airpocket-soundman/pcb_design_test/pcba/README.md

# PCBA production release with M5Bus socket

This directory contains the connector-focused PCBA package derived from the exact upstream reproduction.

## Port mapping

| Port | PCB designators | Required color | LCSC assignment |
|---|---|---|---|
| A | CN2, CN3 | Red | C22390444 / XUNPU WAFER-HY2.0-4PWZ-R62 |
| B | CN4 | Black | hanxia HX-HY2.0-4PWZ-B; obtain the current JLCPCB/LCSC C-number at quotation |
| C | CN5 | Beige / standard | hanxia HX-HY2.0-4PWZ |
| D | CN6 | Beige / standard | hanxia HX-HY2.0-4PWZ |
| E | CN7 | Beige / standard | hanxia HX-HY2.0-4PWZ |

CN1 is the optional vertical Grove connector in the upstream design and is DNP in this release.

## M5Bus

| Side | Designator | LCSC | Part |
|---|---|---|---|
| Top header | J10 | C19630981 | Kinghelm KH-2.54PH-2X15P-L11.0-SMT |
| Bottom low-profile socket | J11 | C41382298 | Yxcon F136-1215A0CMUB1, 3.55 mm insulation height |

Both positions are 2 x 15 and use a 2.54 mm contact grid. J10 retains the imported land pattern. J11 uses the Yxcon recommended 5.82 mm SMD land-row span. The designators are unique J10/J11 identifiers for assembly data.

The original 8.5 mm-high HCTL socket was rejected as too tall. The PCB was then redesigned for the 3.55 mm-high Yxcon F136-1215A0CMUB1 (`C41382298`) rather than forcing that part onto the old 5.04 mm lands. J11 is rotated 270 degrees on the bottom side, and all 30 physical M5Bus positions are routed to the corresponding auxiliary plated holes. A new via connects the final `Net-(J1-Pad1)` position between sides.

## Files

- `JLCPCB-BOM.csv` / `JLCPCB-CPL.csv`: strict ASCII JLCPCB templates with one designator per row; use these if the localized order page rejects the richer export.
- `M5BasicBaseLite-PCBA-JLCPCB-BOM.csv`: UTF-8, comma-separated BOM for direct upload to the JLCPCB order form.
- `M5BasicBaseLite-PCBA-JLCPCB-CPL.csv`: UTF-8, comma-separated five-column CPL for direct upload to the JLCPCB order form.
- `M5BasicBaseLite-PCBA-Production-Gerber.zip`: current socket-equipped fabrication package.
- `M5BasicBaseLite-PCBA-Visual-Final-Gerber.zip`: latest package after the
  browser feedback pass; use this Gerber for the next quotation.
- `M5BasicBaseLite-PCBA-Production-CPL.csv`: filtered placement file containing the 20 populated references only.
- `M5BasicBaseLite-PCBA-Production-BOM.csv`: complete production BOM exported from EasyEDA.
- `M5BasicBaseLite-PCBA-Production.epro2`: editable EasyEDA production project matching these outputs.
- `../EasyEDA/M5BasicBaseLite-Compatible-Final.epro2`: final editable exchange
  project with the reviewed labels and CN3-to-JP2 selector routing.
- `../EasyEDA/visual-final-patch.json` and `../tools/patch_epro2.py`:
  reproducible review patch used to build the final exchange project.
- `M5BasicBaseLite-PCBA-Connector-BOM.csv`: connector sourcing details and DNP decisions.
- Files without `Production` in their names are retained only as historical review artifacts.

## Ordering gates

- This revision is ready to upload for a JLCPCB/JLCPCB Assembly quotation with both M5Bus connectors populated.
- J1, J2, J3, CN1, JP1, JP2, mounting-hole/logo helpers, and auxiliary pads are excluded from assembly. JP1 and JP2 remain as fabricated copper jumpers.
- R1/R2 use `C23162`; U1-U10 use `C5378721`; J10 uses `C19630981`; J11 uses `C41382298`; the two red Port A connectors use `C22390444`.
- The Grove electrical pins are through-hole. Select mixed SMT/THT assembly and confirm wave/manual insertion support.
- Port B is specified by the exact hanxia MPN `HX-HY2.0-4PWZ-B`; request JLCPCB global/custom sourcing during component matching.
- Ports C, D, and E use the exact standard-color hanxia `HX-HY2.0-4PWZ`; request JLCPCB global/custom sourcing during component matching.
- Do not accept an automatic substitute for the Grove connectors without checking color, orientation, and the 2.00 mm land pattern.
- See `VALIDATION.md` for the final DRC, Gerber, BOM, and CPL audit.
