airpocket-soundman/pcb_design_test/full-reproduction/upstream-drc-report.txt

** Drc report for M5BasicBaseLite.kicad_pcb **
** Created on 2026-07-22T16:14:51+0900 **

** Found 220 DRC violations **
[shorting_items]: ２つのネットを短絡するアイテム (ネット Net-(J1-Pad1) と )
    ローカル オーバーライド; error
    @(13.9000 mm, -13.7000 mm): 配線 [Net-(J1-Pad1)] ( Bottom 上、長さ: 0.8000 mm )
    @(13.6000 mm, -13.3000 mm): ポリゴン [<no net>] of JP1 、Bottom 上
[shorting_items]: ２つのネットを短絡するアイテム (ネット  と Net-(CN3-Pad3))
    ローカル オーバーライド; error
    @(35.9000 mm, -4.6000 mm): ポリゴン [<no net>] of JP2 、Bottom 上
    @(35.0000 mm, -4.0000 mm): 配線 [Net-(CN3-Pad3)] ( Bottom 上、長さ: 2.5000 mm )
[clearance]: クリアランス違反 (netclass 'Default' クリアランス 0.1524 mm; 現状 0.1000 mm)
    ルール: netclass 'Default'; error
    @(13.6000 mm, -13.3000 mm): ポリゴン [<no net>] of JP1 、Bottom 上
    @(13.5600 mm, -11.9600 mm): 配線 [/BAT] ( Bottom 上、長さ: 0.4808 mm )
[shorting_items]: ２つのネットを短絡するアイテム (ネット Net-(CN6-Pad13) と unconnected-(CN8-Pad13))
    ローカル オーバーライド; error
    @(3.5000 mm, -27.5400 mm): 配線 [Net-(CN6-Pad13)] ( Bottom 上、長さ: 1.2300 mm )
    @(3.4800 mm, -27.5400 mm): パッド 13 [unconnected-(CN8-Pad13)] - CN8 ( Bottom 上)
[shorting_items]: ２つのネットを短絡するアイテム (ネット Net-(CN6-Pad8) と unconnected-(CN8-Pad8))
    ローカル オーバーライド; error
    @(8.5800 mm, -35.1600 mm): 配線 [Net-(CN6-Pad8)] ( Bottom 上、長さ: 1.3100 mm )
    @(8.5200 mm, -35.1600 mm): パッド 8 [unconnected-(CN8-Pad8)] - CN8 ( Bottom 上)
[shorting_items]: ２つのネットを短絡するアイテム (ネット Net-(CN6-Pad7) と unconnected-(CN8-Pad7))
    ローカル オーバーライド; error
    @(3.5000 mm, -35.1600 mm): 配線 [Net-(CN6-Pad7)] ( Bottom 上、長さ: 1.2300 mm )
    @(3.4800 mm, -35.1600 mm): パッド 7 [unconnected-(CN8-Pad7)] - CN8 ( Bottom 上)
[shorting_items]: ２つのネットを短絡するアイテム (ネット Net-(CN6-Pad6) と unconnected-(CN8-Pad6))
    ローカル オーバーライド; error
    @(8.5800 mm, -37.7000 mm): 配線 [Net-(CN6-Pad6)] ( Bottom 上、長さ: 1.3100 mm )
    @(8.5200 mm, -37.7000 mm): パッド 6 [unconnected-(CN8-Pad6)] - CN8 ( Bottom 上)
[clearance]: クリアランス違反 (netclass 'Default' クリアランス 0.1524 mm; 現状 0.0472 mm)
    ルール: netclass 'Default'; error
    @(36.3000 mm, -4.0000 mm): 配線 [+5V] ( Bottom 上、長さ: 2.4643 mm )
    @(35.9000 mm, -4.6000 mm): ポリゴン [<no net>] of JP2 、Bottom 上
[shorting_items]: ２つのネットを短絡するアイテム (ネット Net-(CN6-Pad6) と unconnected-(CN8-Pad6))
    ローカル オーバーライド; error
    @(7.2500 mm, -37.7300 mm): PTHパッド 1 [Net-(CN6-Pad6)] (REF**)
    @(8.5200 mm, -37.7000 mm): パッド 6 [unconnected-(CN8-Pad6)] - CN8 ( Bottom 上)
[shorting_items]: ２つのネットを短絡するアイテム (ネット Net-(CN6-Pad7) と unconnected-(CN8-Pad7))
    ローカル オーバーライド; error
    @(4.7100 mm, -35.1900 mm): PTHパッド 1 [Net-(CN6-Pad7)] (REF**)
    @(3.4800 mm, -35.1600 mm): パッド 7 [unconnected-(CN8-Pad7)] - CN8 ( Bottom 上)
[shorting_items]: ２つのネットを短絡するアイテム (ネット Net-(CN6-Pad8) と unconnected-(CN8-Pad8))
    ローカル オーバーライド; error
    @(7.2500 mm, -35.1900 mm): PTHパッド 1 [Net-(CN6-Pad8)] (REF**)
    @(8.5200 mm, -35.1600 mm): パッド 8 [unconnected-(CN8-Pad8)] - CN8 ( Bottom 上)
[shorting_items]: ２つのネットを短絡するアイテム (ネット Net-(CN6-Pad9) と unconnected-(CN8-Pad9))
    ローカル オーバーライド; error
    @(4.7100 mm, -32.6500 mm): PTHパッド 1 [Net-(CN6-Pad9)] (REF**)
    @(3.4800 mm, -32.6200 mm): パッド 9 [unconnected-(CN8-Pad9)] - CN8 ( Bottom 上)
[shorting_items]: ２つのネットを短絡するアイテム (ネット Net-(CN6-Pad11) と unconnected-(CN8-Pad11))
    ローカル オーバーライド; error
    @(4.7100 mm, -30.1100 mm): PTHパッド 1 [Net-(CN6-Pad11)] (REF**)
    @(3.4800 mm, -30.0800 mm): パッド 11 [unconnected-(CN8-Pad11)] - CN8 ( Bottom 上)
[shorting_items]: ２つのネットを短絡するアイテム (ネット Net-(CN6-Pad14) と unconnected-(CN8-Pad14))
    ローカル オーバーライド; error
    @(7.2500 mm, -27.5700 mm): PTHパッド 1 [Net-(CN6-Pad14)] (REF**)
    @(8.5200 mm, -27.5400 mm): パッド 14 [unconnected-(CN8-Pad14)] - CN8 ( Bottom 上)
[shorting_items]: ２つのネットを短絡するアイテム (ネット Net-(CN6-Pad13) と unconnected-(CN8-Pad13))
    ローカル オーバーライド; error
    @(4.7100 mm, -27.5700 mm): PTHパッド 1 [Net-(CN6-Pad13)] (REF**)
    @(3.4800 mm, -27.5400 mm): パッド 13 [unconnected-(CN8-Pad13)] - CN8 ( Bottom 上)
[shorting_items]: ２つのネットを短絡するアイテム (ネット Net-(CN6-Pad25) と unconnected-(CN8-Pad25))
    ローカル オーバーライド; error
    @(4.7100 mm, -12.3300 mm): PTHパッド 1 [Net-(CN6-Pad25)] (REF**)
    @(3.4800 mm, -12.3000 mm): パッド 25 [unconnected-(CN8-Pad25)] - CN8 ( Bottom 上)
[shorting_items]: ２つのネットを短絡するアイテム (ネット Net-(CN6-Pad24) と unconnected-(CN8-Pad24))
    ローカル オーバーライド; error
    @(7.2500 mm, -14.8700 mm): PTHパッド 1 [Net-(CN6-Pad24)] (REF**)
    @(8.5200 mm, -14.8400 mm): パッド 24 [unconnected-(CN8-Pad24)] - CN8 ( Bottom 上)
[shorting_items]: ２つのネットを短絡するアイテム (ネット Net-(CN6-Pad29) と unconnected-(CN8-Pad29))
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
[silk_overlap]: シルクスクリーンのオーバーラップ
    ルール: board setup constraints silk; warning
    @(29.5000 mm, -32.5000 mm): R1のリファレンスフィールド
    @(29.5000 mm, -32.0000 mm): R2のリファレンスフィールド

** Found 0 unconnected pads **

** Found 0 Footprint errors **

** End of Report **
