airpocket-soundman/pcb_design_test/pcba/M5BasicBaseLite-PCBA-Connector-BOM.csv

Designator | Port | Color | Quantity | Manufacturer | Manufacturer Part | LCSC Part | Assembly | Status
CN2 CN3 | A | Red | 2 | XUNPU | WAFER-HY2.0-4PWZ-R62 | C22390444 | THT / wave solder | LCSC matched
CN4 | B | Black | 1 | hanxia | HX-HY2.0-4PWZ-B |  | THT / wave solder | Exact MPN selected - obtain JLCPCB/LCSC C-number at quotation
CN5 | C | Beige / standard | 1 | hanxia | HX-HY2.0-4PWZ |  | THT / wave solder | Exact MPN selected - obtain JLCPCB/LCSC C-number at quotation
CN6 | D | Beige / standard | 1 | hanxia | HX-HY2.0-4PWZ |  | THT / wave solder | Exact MPN selected - obtain JLCPCB/LCSC C-number at quotation
CN7 | E | Beige / standard | 1 | hanxia | HX-HY2.0-4PWZ |  | THT / wave solder | Exact MPN selected - obtain JLCPCB/LCSC C-number at quotation
J10 | M5Bus top | Black | 1 | Kinghelm | KH-2.54PH-2X15P-L11.0-SMT | C19630981 | Top SMT | LCSC matched
J11 | M5Bus bottom | Black | 1 | Yxcon | F136-1215A0CMUB1 | C41382298 | Bottom SMT | LCSC matched; 3.55 mm low-profile socket; PCB rerouted for 5.82 mm land span
CN1 | Optional vertical Grove | Unspecified | 1 |  |  |  | DNP | Not populated
