airpocket-soundman/pcb_design_test/full-reproduction/M5BasicBaseLite-Full-BOM.csv

Supplier | Supplier Part | Manufacturer | Manufacturer Part | Value | Footprint | Designator | Comment | Quantity | No.
 |  |  |  | CON_GROVEV | M5GObase_sub:CON_GROVE_V | CN1 | CON_GROVEV | 1 | 1
 |  |  |  |  | M5GObase_sub:CON_GROVE_H | CN2,CN3,CN4,CN5,CN7 | CON_GROVEH | 5 | 2
 |  |  |  | CON_GROVEH | M5GObase_sub:CON_GROVE_H | CN6 | CON_GROVEH | 1 | 3
 |  |  |  |  | Connector_PinHeader_2.54mm:PinHeader_2x15_P2.54mm_Vertical_SMD | CN7 | PinHeader_2x15_P2.54mm_Vertical_SMD | 1 | 4
 |  |  |  | MBUS_bottom | Connector_PinSocket_2.54mm:PinSocket_2x15_P2.54mm_Vertical_SMD | CN8 | MBUS_bottom | 1 | 5
 |  |  |  | Conn_01x02_Female | Connector_JST:JST_PH_S2B-PH-K_1x02_P2.00mm_Horizontal | J1 | Conn_01x02_Female | 1 | 6
 |  |  |  | Conn_01x02_Female | Connector_PinHeader_2.54mm:PinHeader_1x02_P2.54mm_Horizontal | J2 | Conn_01x02_Female | 1 | 7
 |  |  |  | Conn_01x08_Female | Connector_PinSocket_2.54mm:PinSocket_1x08_P2.54mm_Horizontal | J3 | Conn_01x08_Female | 1 | 8
 |  |  |  | SolderJumper_2_Bridged | Jumper:SolderJumper-2_P1.3mm_Bridged_Pad1.0x1.5mm | JP1 | SolderJumper_2_Bridged | 1 | 9
 |  |  |  | SolderJumper_3_Bridged12 | Jumper:SolderJumper-3_P1.3mm_Bridged2Bar12_Pad1.0x1.5mm | JP2 | SolderJumper_3_Bridged12 | 1 | 10
 |  |  |  |  | MountingHole:MountingHole_3.2mm_M3 | MH1,MH1,MH1,MH2 | MountingHole_3.2mm_M3 | 4 | 11
 |  |  |  |  | MountingHole:MountingHole_2.1mm | MH5,MH5,MH5,MH5 | MountingHole_2.1mm | 4 | 12
 |  |  |  | 4.7k | M5GObase_sub:0603 | R1 | 4.7k | 1 | 13
 |  |  |  |  | M5GObase_sub:0603 | R2 | 4.7k | 1 | 14
 |  |  |  |  | Symbol:OSHW-Logo_5.7x6mm_SilkScreen | REF** | OSHW-Logo_5.7x6mm_SilkScreen | 1 | 15
 |  |  |  |  | akita:MountingHole_1mm | REF**,REF**,REF**,REF** | MountingHole_1mm | 4 | 16
 |  |  |  |  | akita:Pad_TH09mm | REF**,REF**,REF**,REF**,REF**,REF**,REF**,REF**,REF**,REF**,REF**,REF**,REF**,REF**,REF**,REF**,REF**,REF**,REF**,REF**,REF**,REF**,REF**,REF**,REF**,REF**,REF**,REF**,REF** | Pad_TH09mm | 29 | 17
 |  |  |  |  | akita:LED_SK6812SIDE | U1,U2,U3,U5,U6,U7,U8,U9,U10 | LED_SK6812side | 9 | 18
 |  |  |  | LED_SK6812side | akita:LED_SK6812SIDE | U4 | LED_SK6812side | 1 | 19
