airpocket-soundman/pcb_design_test/fabrication/M5BasicBaseLite-Compatible-BOM.csv

Supplier | Supplier Part | Manufacturer | Manufacturer Part | Value | Footprint | Designator | Comment | Quantity | No.
LCSC | C22390454 | XUNPU | WAFER-HY2.0-4PWZ-H62 |  | CONN-SMD_4P-P2.00_HY2.0_S90_4P | J1,J2,J3,J4,J5,J6 | WAFER-HY2.0-4PWZ-H62 | 6 | 1
LCSC | C19630981 | KINGHELM | KH-2.54PH-2X15P-L11.0-SMT |  | HDR-SMD_30P-P2.54-V-M-R2-C15-S7.4 | J7 | KH-2.54PH-2X15P-L11.0-SMT | 1 | 2
LCSC | 0603WAF4701T5E.1 | UNI-ROYAL(厚声) | 0603WAF4701T5E |  | R0603 | R1,R2 | 4.7k | 2 | 3
