airpocket-soundman/pcb_design_test/(list of files, drawings)

Other design files:
EasyEDA/visual-final-patch.json
fabrication/M5BasicBaseLite-Compatible.dsn
