airpocket-soundman/pcb_design_test/upstream/M5BasicBaseLite.kicad_pcb

## KiCad design upstream/M5BasicBaseLite.kicad_pcb (2026-07-22)

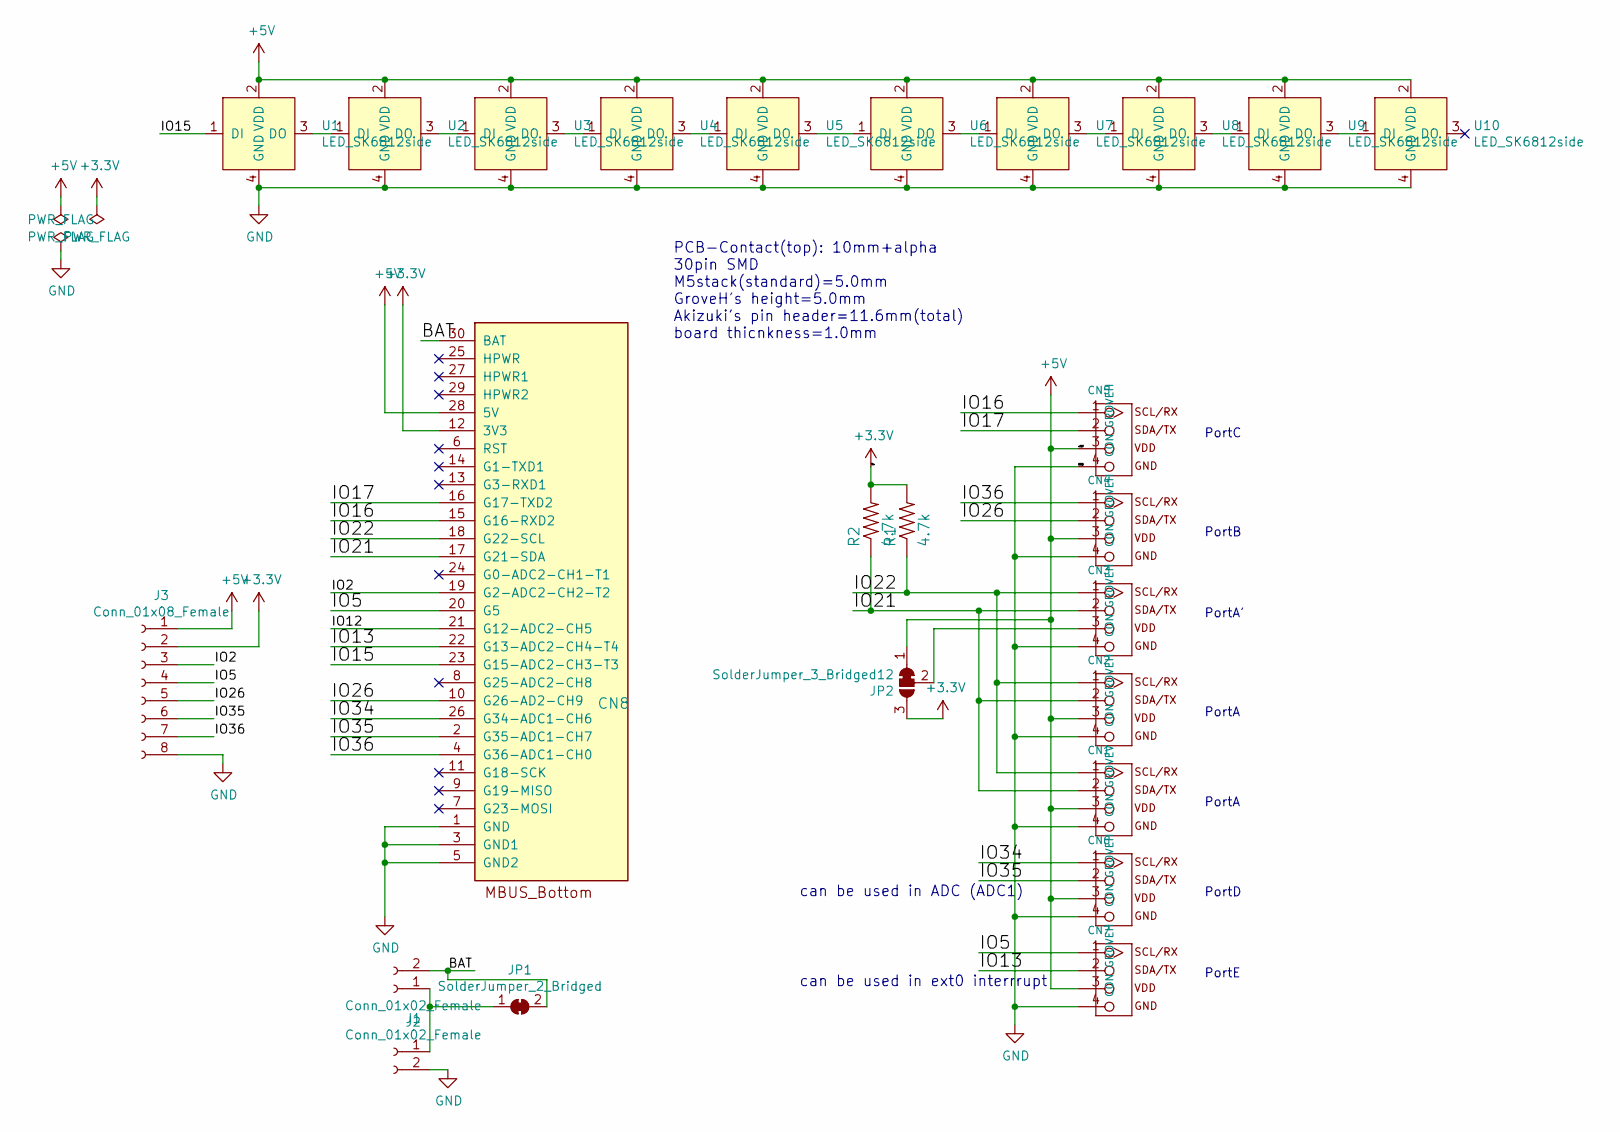
[picture p1: schematic M5BasicBaseLite.kicad_sch]

Parts:
CN1: CON_GROVEV; CON_GROVE_V
CN2, CN3, CN4, CN5, CN6, CN7: CON_GROVEH; CON_GROVE_H
CN8: MBUS_bottom; PinSocket_2x15_P2.54mm_Vertical_SMD
J1: Conn_01x02_Female; JST_PH_S2B-PH-K_1x02_P2.00mm_Horizontal
J2: Conn_01x02_Female; PinHeader_1x02_P2.54mm_Horizontal
J3: Conn_01x08_Female; PinSocket_1x08_P2.54mm_Horizontal
JP1: SolderJumper_2_Bridged; SolderJumper-2_P1.3mm_Bridged_Pad1.0x1.5mm
JP2: SolderJumper_3_Bridged12; SolderJumper-3_P1.3mm_Bridged2Bar12_Pad1.0x1.5mm
R1, R2: 4.7k; 0603
U1, U2, U3, U4, U5, U6, U7, U8, U9, U10: LED_SK6812side; LED_SK6812SIDE

Connections:
+3V3: CN8.12 (3V3), J3.2, JP2.3 (B), R1.2, R2.2; also elsewhere on the board
+5V: CN1.3, CN2.3, CN4.3, CN5.3, CN6.3, CN7.3, CN8.28 (5V), J3.1, JP2.1 (A), U1.2 (VDD), U2.2 (VDD), U3.2 (VDD), U4.2 (VDD), U5.2 (VDD), U6.2 (VDD), U7.2 (VDD), U8.2 (VDD), U9.2 (VDD), U10.2 (VDD); also elsewhere on the board
/BAT: CN8.30 (BAT), J2.2, JP1.2 (B)
/IO2: CN8.19 (G2-ADC2-CH2-T2), J3.3; also elsewhere on the board
/IO5: CN7.1, CN8.20 (G5), J3.4; also elsewhere on the board
/IO12: CN8.21 (G12-ADC2-CH5); also elsewhere on the board
/IO13: CN7.2, CN8.22 (G13-ADC2-CH4-T4); also elsewhere on the board
/IO15: CN8.23 (G15-ADC2-CH3-T3), U1.1 (DI); also elsewhere on the board
/IO16: CN5.1, CN8.15 (G16-RXD2); also elsewhere on the board
/IO17: CN5.2, CN8.16 (G17-TXD2); also elsewhere on the board
/IO21: CN1.2, CN2.2, CN3.2, CN8.17 (G21-SDA), R2.1; also elsewhere on the board
/IO22: CN1.1, CN2.1, CN3.1, CN8.18 (G22-SCL), R1.1; also elsewhere on the board
/IO26: CN4.2, CN8.10 (G26-AD2-CH9), J3.5; also elsewhere on the board
/IO34: CN6.1, CN8.26 (G34-ADC1-CH6); also elsewhere on the board
/IO35: CN6.2, CN8.2 (G35-ADC1-CH7), J3.6; also elsewhere on the board
/IO36: CN4.1, CN8.4 (G36-ADC1-CH0), J3.7; also elsewhere on the board
GND: CN1.4, CN2.4, CN3.4, CN4.4, CN5.4, CN6.4, CN7.4, CN8.1 (GND), CN8.3 (GND1), CN8.5 (GND2), J1.2, J3.8, U1.4 (GND), U2.4 (GND), U3.4 (GND), U4.4 (GND), U5.4 (GND), U6.4 (GND), U7.4 (GND), U8.4 (GND), U9.4 (GND), U10.4 (GND); also elsewhere on the board
unnamed: CN3.3, JP2.2 (C)
unnamed 29: J1.1, J2.1, JP1.1 (A); also elsewhere on the board
unnamed: U1.3 (DO), U2.1 (DI)
unnamed: U2.3 (DO), U3.1 (DI)
unnamed: U3.3 (DO), U4.1 (DI)
unnamed: U4.3 (DO), U5.1 (DI)
unnamed: U5.3 (DO), U6.1 (DI)
unnamed: U6.3 (DO), U7.1 (DI)
unnamed: U7.3 (DO), U8.1 (DI)
unnamed: U8.3 (DO), U9.1 (DI)
unnamed: U9.3 (DO), U10.1 (DI)

Notes on the sheet:
PortA
can be used in ADC (ADC1)
PCB-Contact(top): 10mm+alpha 30pin SMD M5stack(standard)=5.0mm GroveH's height=5.0mm Akizuki's pin header=11.6mm(total) board thicnkness=1.0mm
PortE
PortC
PortA'
PortB
can be used in ext0 interrrupt
PortD

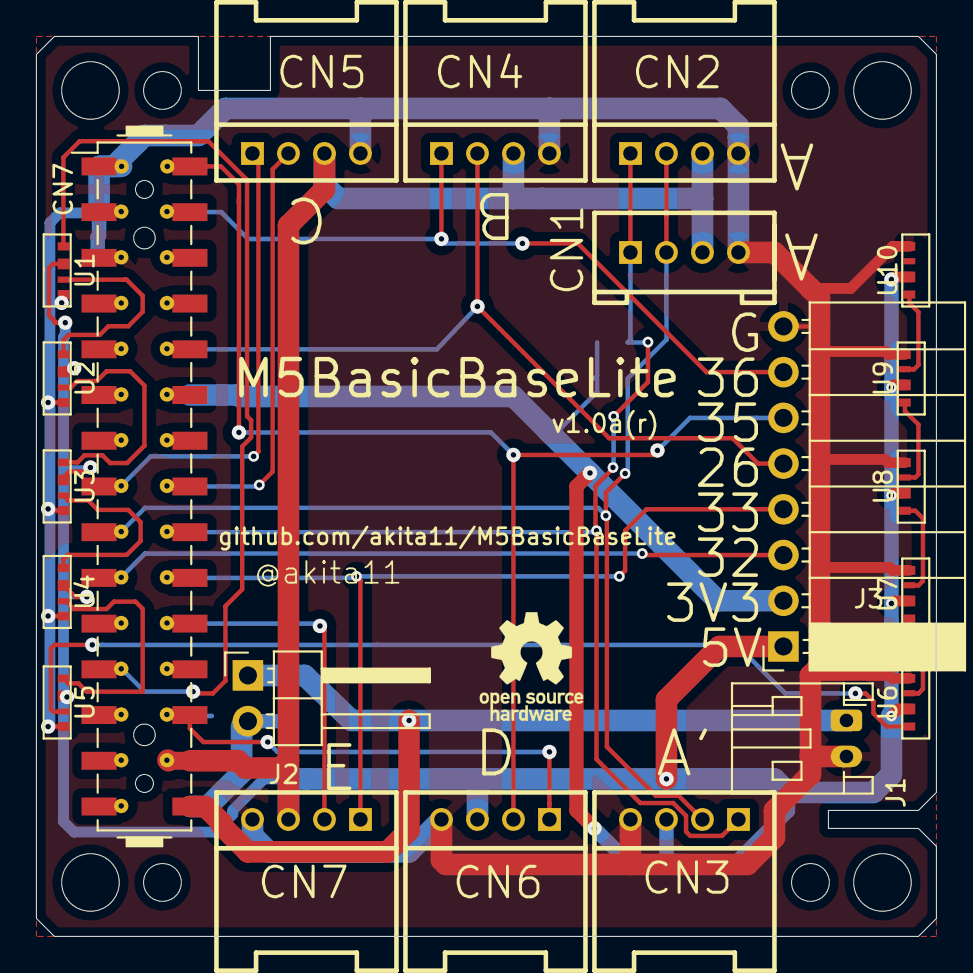
[picture p2: board M5BasicBaseLite.kicad_pcb from above]

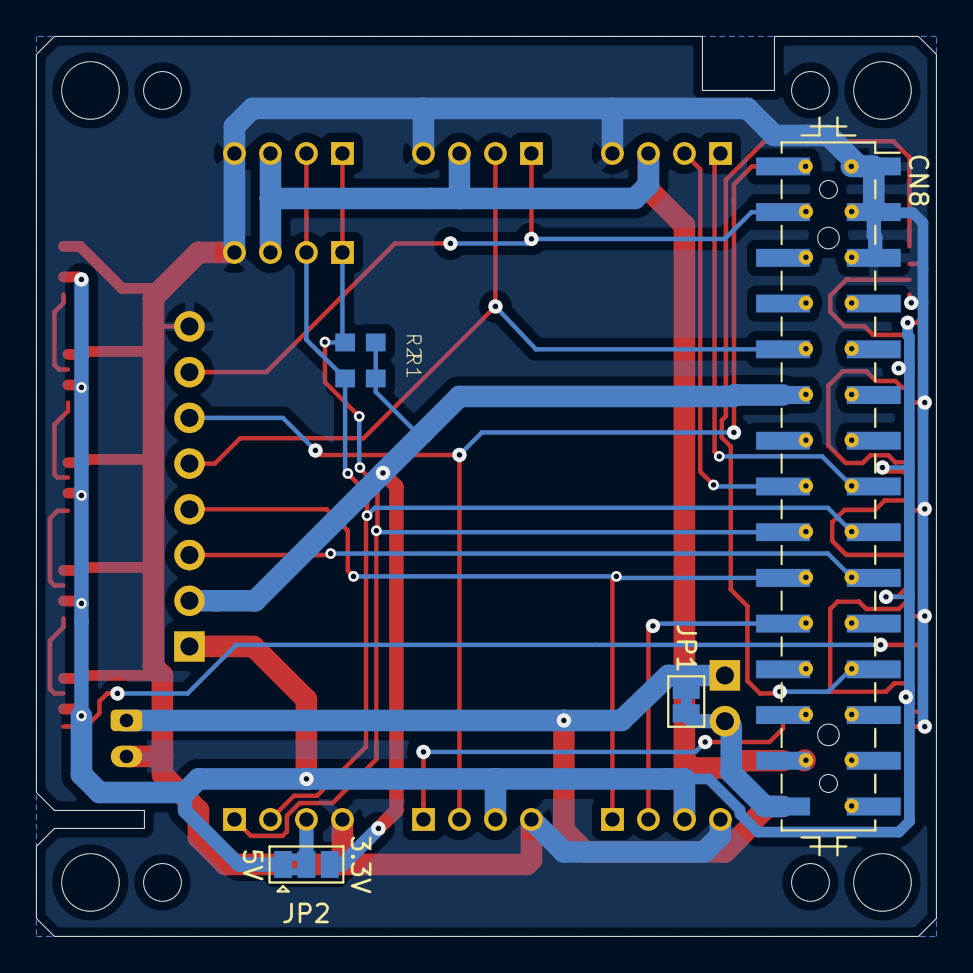
[picture p3: board M5BasicBaseLite.kicad_pcb from below]

Board: 2 copper layers, 50.0 x 50.0 mm, 34 parts (5 on the bottom side), 28 nets.

Other parts of the board:
CN7#2: PinHeader_2x15_P2.54mm_Vertical_SMD
MH1, MH1#2, MH1#3, MH2: MountingHole_3.2mm_M3
MH5, MH5#2, MH5#3, MH5#4: MountingHole_2.1mm

Their connections:
+3V3: CN7#2.12; also elsewhere on the board
+5V: CN7#2.28; also elsewhere on the board
/IO2: CN7#2.19; also elsewhere on the board
/IO5: CN7#2.20; also elsewhere on the board
/IO12: CN7#2.21; also elsewhere on the board
/IO13: CN7#2.22; also elsewhere on the board
/IO15: CN7#2.23; also elsewhere on the board
/IO16: CN7#2.15; also elsewhere on the board
/IO17: CN7#2.16; also elsewhere on the board
/IO21: CN7#2.17; also elsewhere on the board
/IO22: CN7#2.18; also elsewhere on the board
/IO26: CN7#2.10; also elsewhere on the board
/IO34: CN7#2.26; also elsewhere on the board
/IO35: CN7#2.2; also elsewhere on the board
/IO36: CN7#2.4; also elsewhere on the board
GND: CN7#2.1, CN7#2.3, CN7#2.5; also elsewhere on the board
unnamed 29: CN7#2.30; also elsewhere on the board
