airpocket-soundman/pcb_design_test/(commit log)

2026-07-22 Complete EasyEDA M5BasicBaseLite compatible PCB design
    [M5BasicBaseLite-Compatible-BOM.csv, M5BasicBaseLite-Compatible.dsn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]
2026-07-22 Add complete upstream EasyEDA reproduction
    [M5BasicBaseLite-Full-BOM.csv, M5BasicBaseLite.kicad_pcb, M5BasicBaseLite.kicad_sch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]
2026-07-22 Add connector-focused PCBA package
    [M5BasicBaseLite-PCBA-Connector-BOM.csv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]
2026-07-22 Use hanxia black Grove connector for port B
    [M5BasicBaseLite-PCBA-Connector-BOM.csv]
2026-07-22 Use standard hanxia Grove connectors for ports C D E
    [M5BasicBaseLite-PCBA-Connector-BOM.csv]
2026-07-22 Use low-profile M5Bus socket
    [M5BasicBaseLite-PCBA-Connector-BOM.csv]
2026-07-22 Block PCBA release after footprint validation
    [M5BasicBaseLite-PCBA-Connector-BOM.csv]
2026-07-22 Prepare header-only PCBA production release
    [M5BasicBaseLite-PCBA-Connector-BOM.csv, M5BasicBaseLite-PCBA-Production-BOM.csv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]
2026-07-22 Add low-profile M5Bus socket to PCBA release
    [M5BasicBaseLite-PCBA-Connector-BOM.csv, M5BasicBaseLite-PCBA-Production-BOM.csv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]
2026-07-22 Add JLCPCB-compatible BOM and CPL files
    [M5BasicBaseLite-PCBA-JLCPCB-BOM.csv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]
2026-07-22 Add official-template JLCPCB assembly files
    [JLCPCB-BOM.csv, JLCPCB-BOM.xlsx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]
2026-07-24 Complete visual feedback PCB revision
    [visual-final-patch.json]
